SmartCar2023/SmartCar/anschlussplan/Anschlussplan Gabellichtschranke.pdf

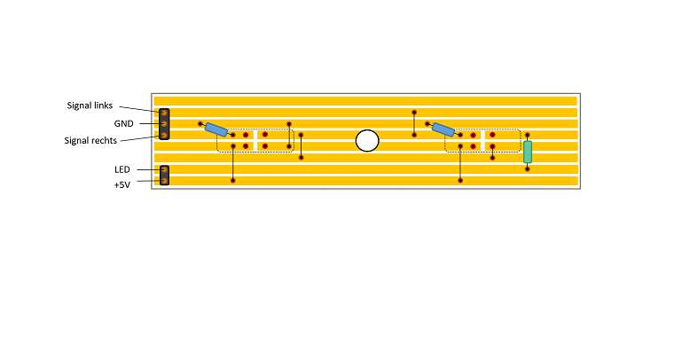
[picture p1: figure]
