SmartCar2023/SmartCar/anschlussplan/Anschlussplan.pdf

## II Anhang

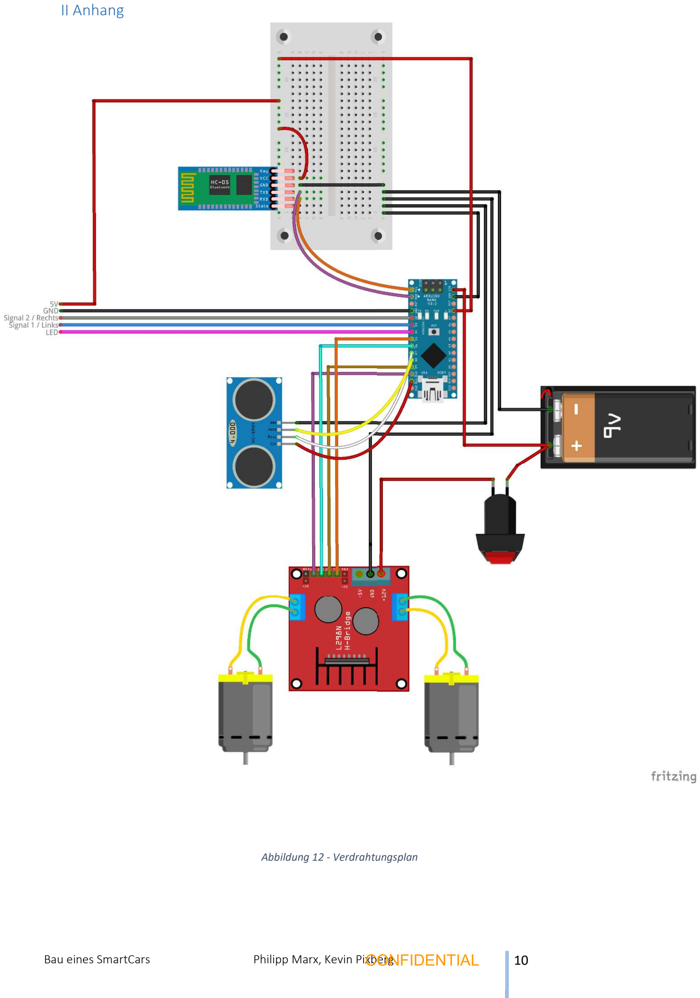
[picture p2: page 1]

Bau eines SmartCars | Philipp Marx, Kevin Pixberg CONFIDENTIAL | 10

Abbildung 12 - Verdrahtungsplan
