SmartCar2023/SmartCar/stl/Smart_car_Distanz_Platine.stl

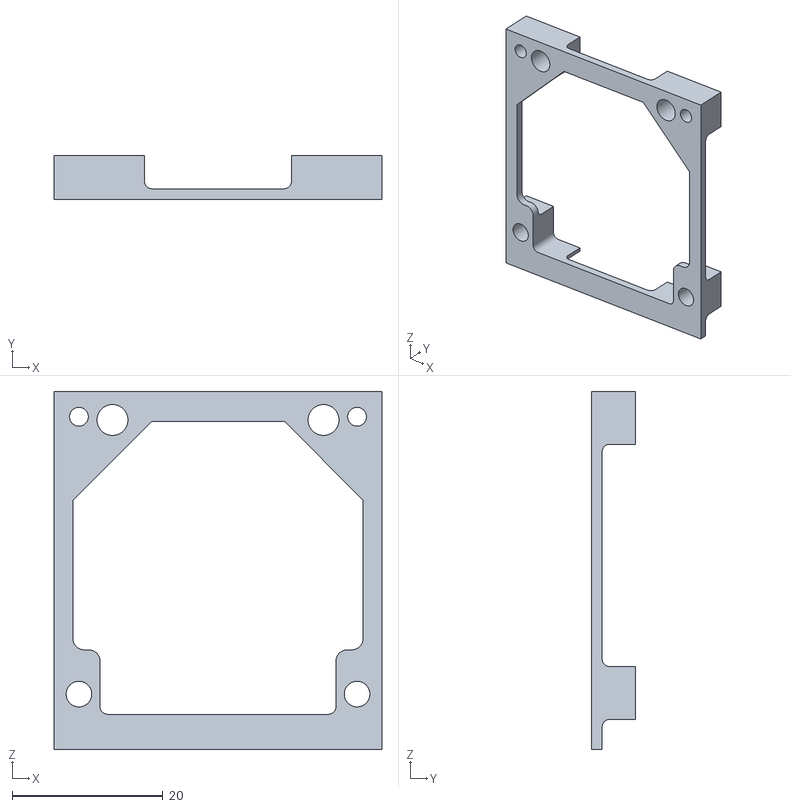
[picture p3: CAD file, 2023-07-24]
stl/Smart_car_Distanz_Platine.stl
43.5 x 5.80 x 47.5
