SmartCar2023/SmartCar/stl/Smart_car_Distanz_Breadboard.stl

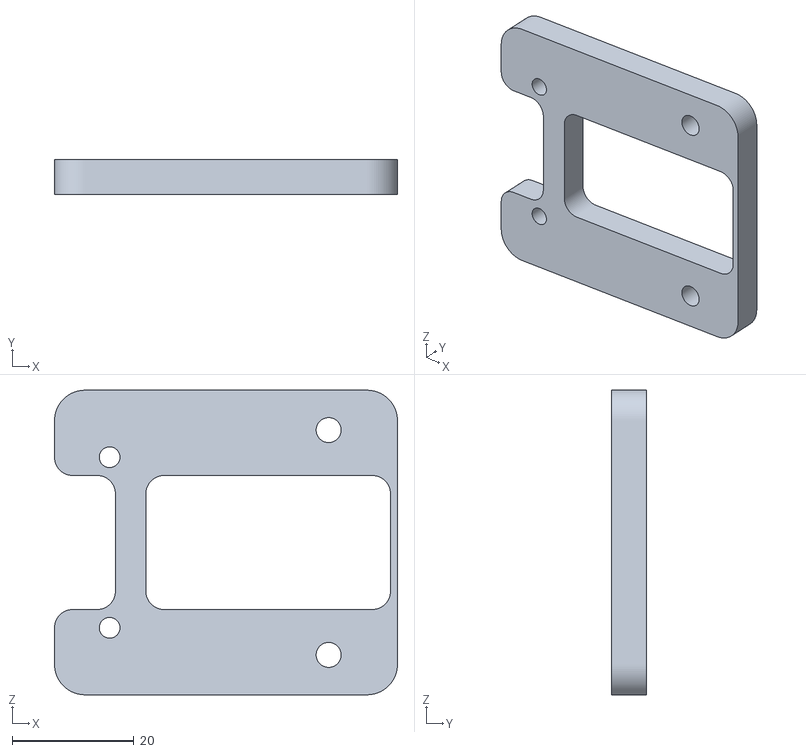
[picture p4: CAD file, 2023-07-24]
stl/Smart_car_Distanz_Breadboard.stl
56.3 x 5.70 x 50.0
