SmartCar2023/SmartCar/stl/Smart_car_Batteriefachhalter.stl

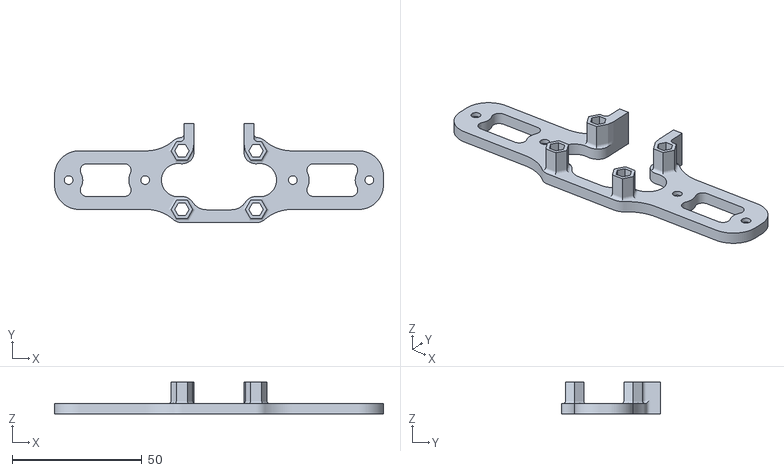
[picture p5: CAD file, 2023-07-24]
stl/Smart_car_Batteriefachhalter.stl
126.9 x 38.4 x 12.3
