SmartCar2023/SmartCar/stl/Smart_car_Halter_Sensor.stl

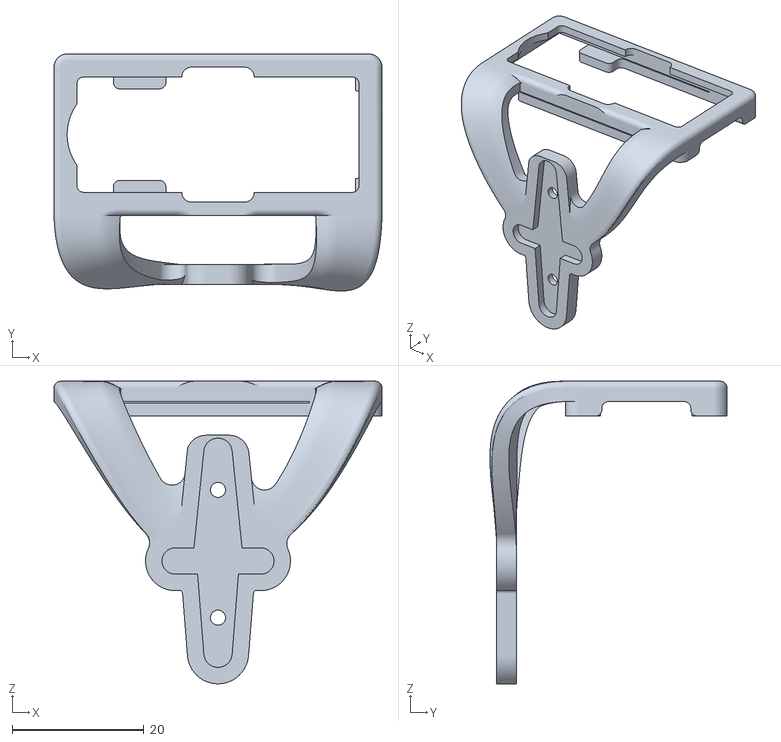
[picture p6: CAD file, 2023-07-24]
stl/Smart_car_Halter_Sensor.stl
49.8 x 36.0 x 45.9
