SmartCar2023/SmartCar/stl/Smart_car_Adapter_Arduino.stl

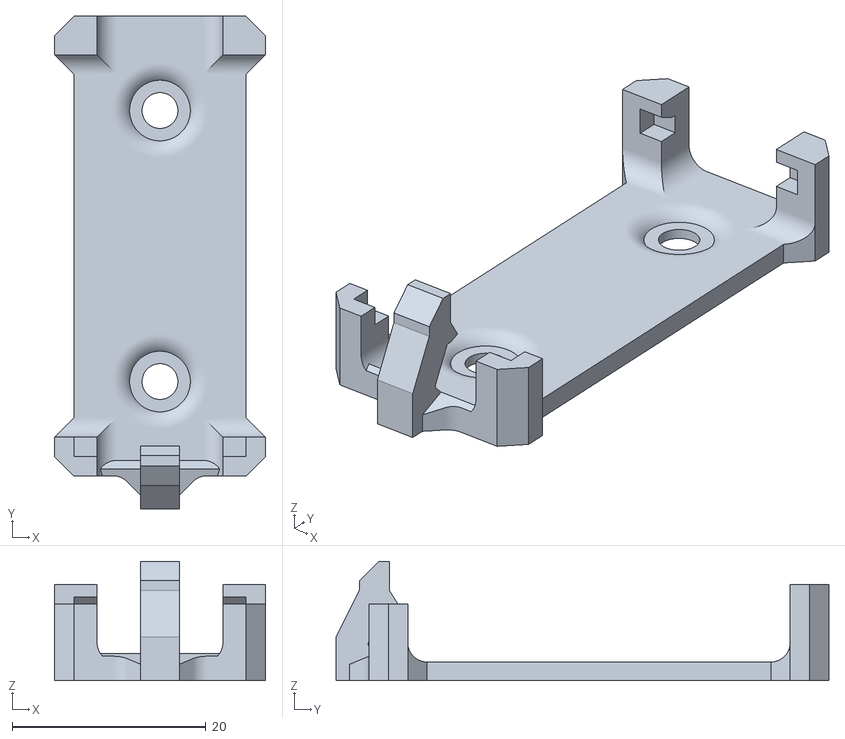
[picture p7: CAD file, 2023-07-24]
stl/Smart_car_Adapter_Arduino.stl
21.8 x 50.9 x 12.3
