SmartCar2023/SmartCar/stl/Smart_car_Buegel_rechts.stl

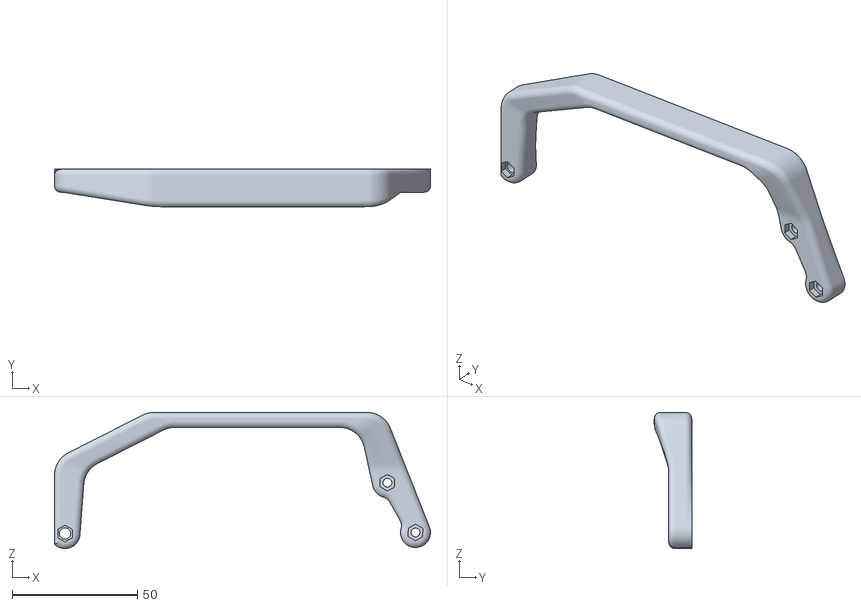
[picture p8: CAD file, 2023-07-24]
stl/Smart_car_Buegel_rechts.stl
150.3 x 15.0 x 54.4
