SmartCar2023/SmartCar/stl/Smart_car_Adapter_Servo.stl

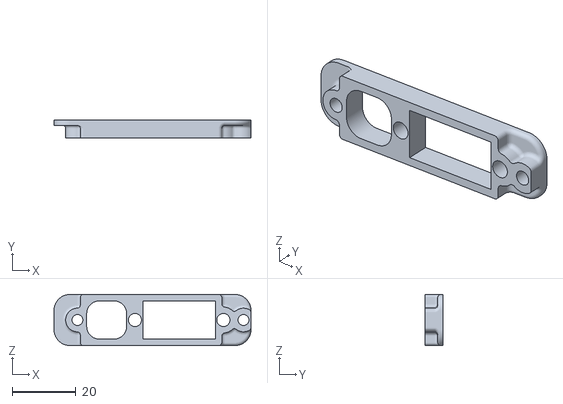
[picture p9: CAD file, 2023-07-24]
stl/Smart_car_Adapter_Servo.stl
61.7 x 5.70 x 16.0
