SmartCar2023/SmartCar/(list of files, cad)

Other CAD files:
stl/Smart_car_Buegel_links.stl
